zandr/birdnet-mic-halow/releases/2026-10-17/evidence/viewer-review.md

# Visual export review — 2026-10-17

Opened the fresh Fabrication-birdnet-mic-hat.zip in KiCad GerbView. All 11 Gerbers and both drill files loaded. The ZIP importer skipped only the job metadata, as expected; that file remains included in the archive.

Inspected top copper/mask/silk with drills and outline, bottom copper/mask/paste with outline and drills, top paste with In1.Cu, and In2.Cu separately. Registration, board perimeter/notch, jack locating holes and connector pads appear consistent; no obvious export defects observed. Both front-layer PDM routes are present. Bottom silk is intentionally empty. This is a visual export check, not vendor DFM or stencil approval; U1 exposed-pad paste treatment still requires assembler review.

Rendered the schematic and both assembly locator pages to PNG and inspected them. All pages contain the expected drawing, readable labels, fitted/DNP distinction and pin-1 markers; bottom locator is viewed from below. Native fabrication PDF is supplemental.

JLCPCB placement preview, exact ADC sourcing, physical jack-switch test and enclosure/acoustic clearance validation remain outstanding.
