zandr/birdnet-mic-halow/releases/2026-10-17/BOM-birdnet-mic-hat.csv

Comment | Designator | Footprint | LCSC Part # | MPN | Manufacturer | Quantity
1uF | C1,C4,C5,C6,C8,C9 | Capacitor_SMD:C_0402_1005Metric | C167339 | 0402X105K160NT | FH | 6
1uF | C2,C10 | Capacitor_SMD:C_0603_1608Metric | C106248 | CC0603KRX7R7BB105 | YAGEO | 2
0.1uF | C7,C12 | Capacitor_SMD:C_0402_1005Metric | C60474 | CC0402KRX7R7BB104 | YAGEO | 2
PJ-327A0-SMT | J1 | BirdNetMicHat:Jack_3.5mm_PJ-327A0-SMT | C381135 | PJ-327A0-SMT | XKB Connection | 1
DF40HC(3.5)-30DS-0.4V(51) | J3 | BirdNetMicHat:DF40_30_LongWave_Hat | C597945 | DF40HC(3.5)-30DS-0.4V(51) | Hirose | 1
MSM261DGT003 | MK1 | BirdNetMicHat:MSM261DGT003 | C48227730 | MSM261DGT003 | MEMS | 1
MMBT3904 | Q1 | Package_TO_SOT_SMD:SOT-23 | C20526 | MMBT3904 | JSCJ | 1
2.2k | R1 | Resistor_SMD:R_0402_1005Metric | C25879 | 0402WGF2201TCE | UNI-ROYAL | 1
10k | R3,R4,R5 | Resistor_SMD:R_0402_1005Metric | C25744 | 0402WGF1002TCE | UNI-ROYAL | 3
47k | R6 | Resistor_SMD:R_0402_1005Metric | C25792 | 0402WGF4702TCE | UNI-ROYAL | 1
100k | R7 | Resistor_SMD:R_0402_1005Metric | C25741 | 0402WGF1003TCE | UNI-ROYAL | 1
1M | R8 | Resistor_SMD:R_0402_1005Metric | C26083 | 0402WGF1004TCE | UNI-ROYAL | 1
TLV320ADC5140 | U1 | ADC5140_FP:RTW24_4P15X4P15_TEX |  | TLV320ADC5140IRTWR | Texas Instruments | 1
TPS7A2033PDBVR | U2 | Package_TO_SOT_SMD:SOT-23-5 | C2862740 | TPS7A2033PDBVR | Texas Instruments | 1
