zandr/birdnet-mic-halow/releases/2026-10-17/Assembly-placement.pdf

# BirdNET microphone HAT | TOP

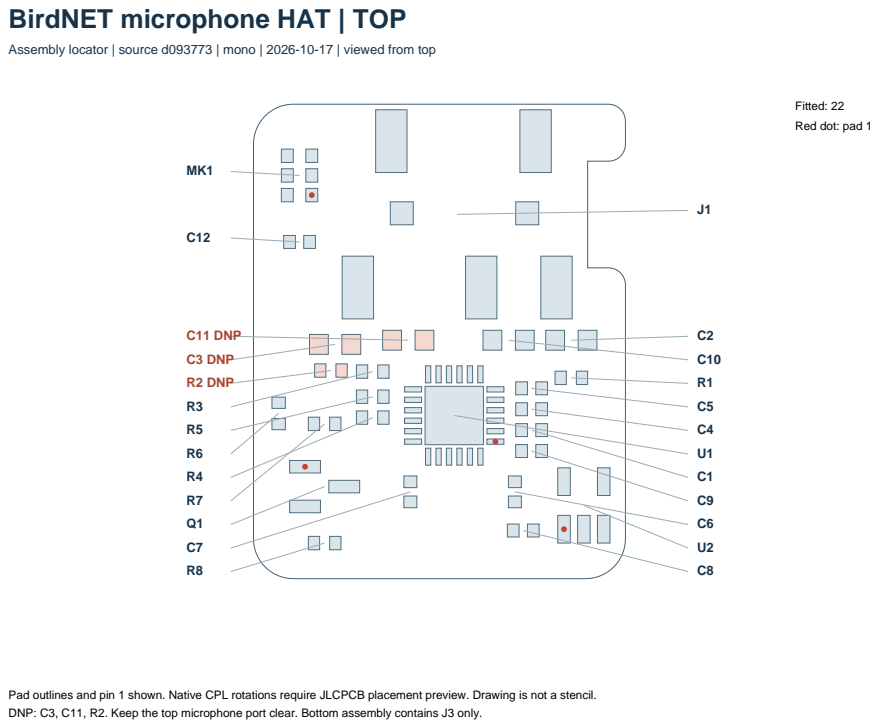
[picture p1: page 1]

Assembly locator | source d093773 | mono | 2026-10-17 | viewed from top

Pad outlines and pin 1 shown. Native CPL rotations require JLCPCB placement preview. Drawing is not a stencil.
DNP: C3, C11, R2. Keep the top microphone port clear. Bottom assembly contains J3 only.

# BirdNET microphone HAT | BOTTOM

Assembly locator | source d093773 | mono | 2026-10-17 | viewed from bottom

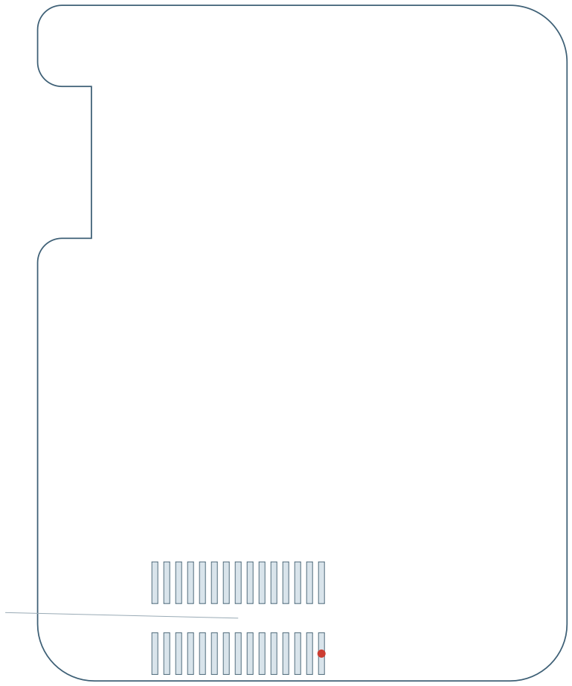
[picture p2: figure]
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

J3

Fitted: 1
Red dot: pad 1
