zandr/birdnet-mic-halow/releases/2026-10-17/Schematic-birdnet-mic-hat.pdf

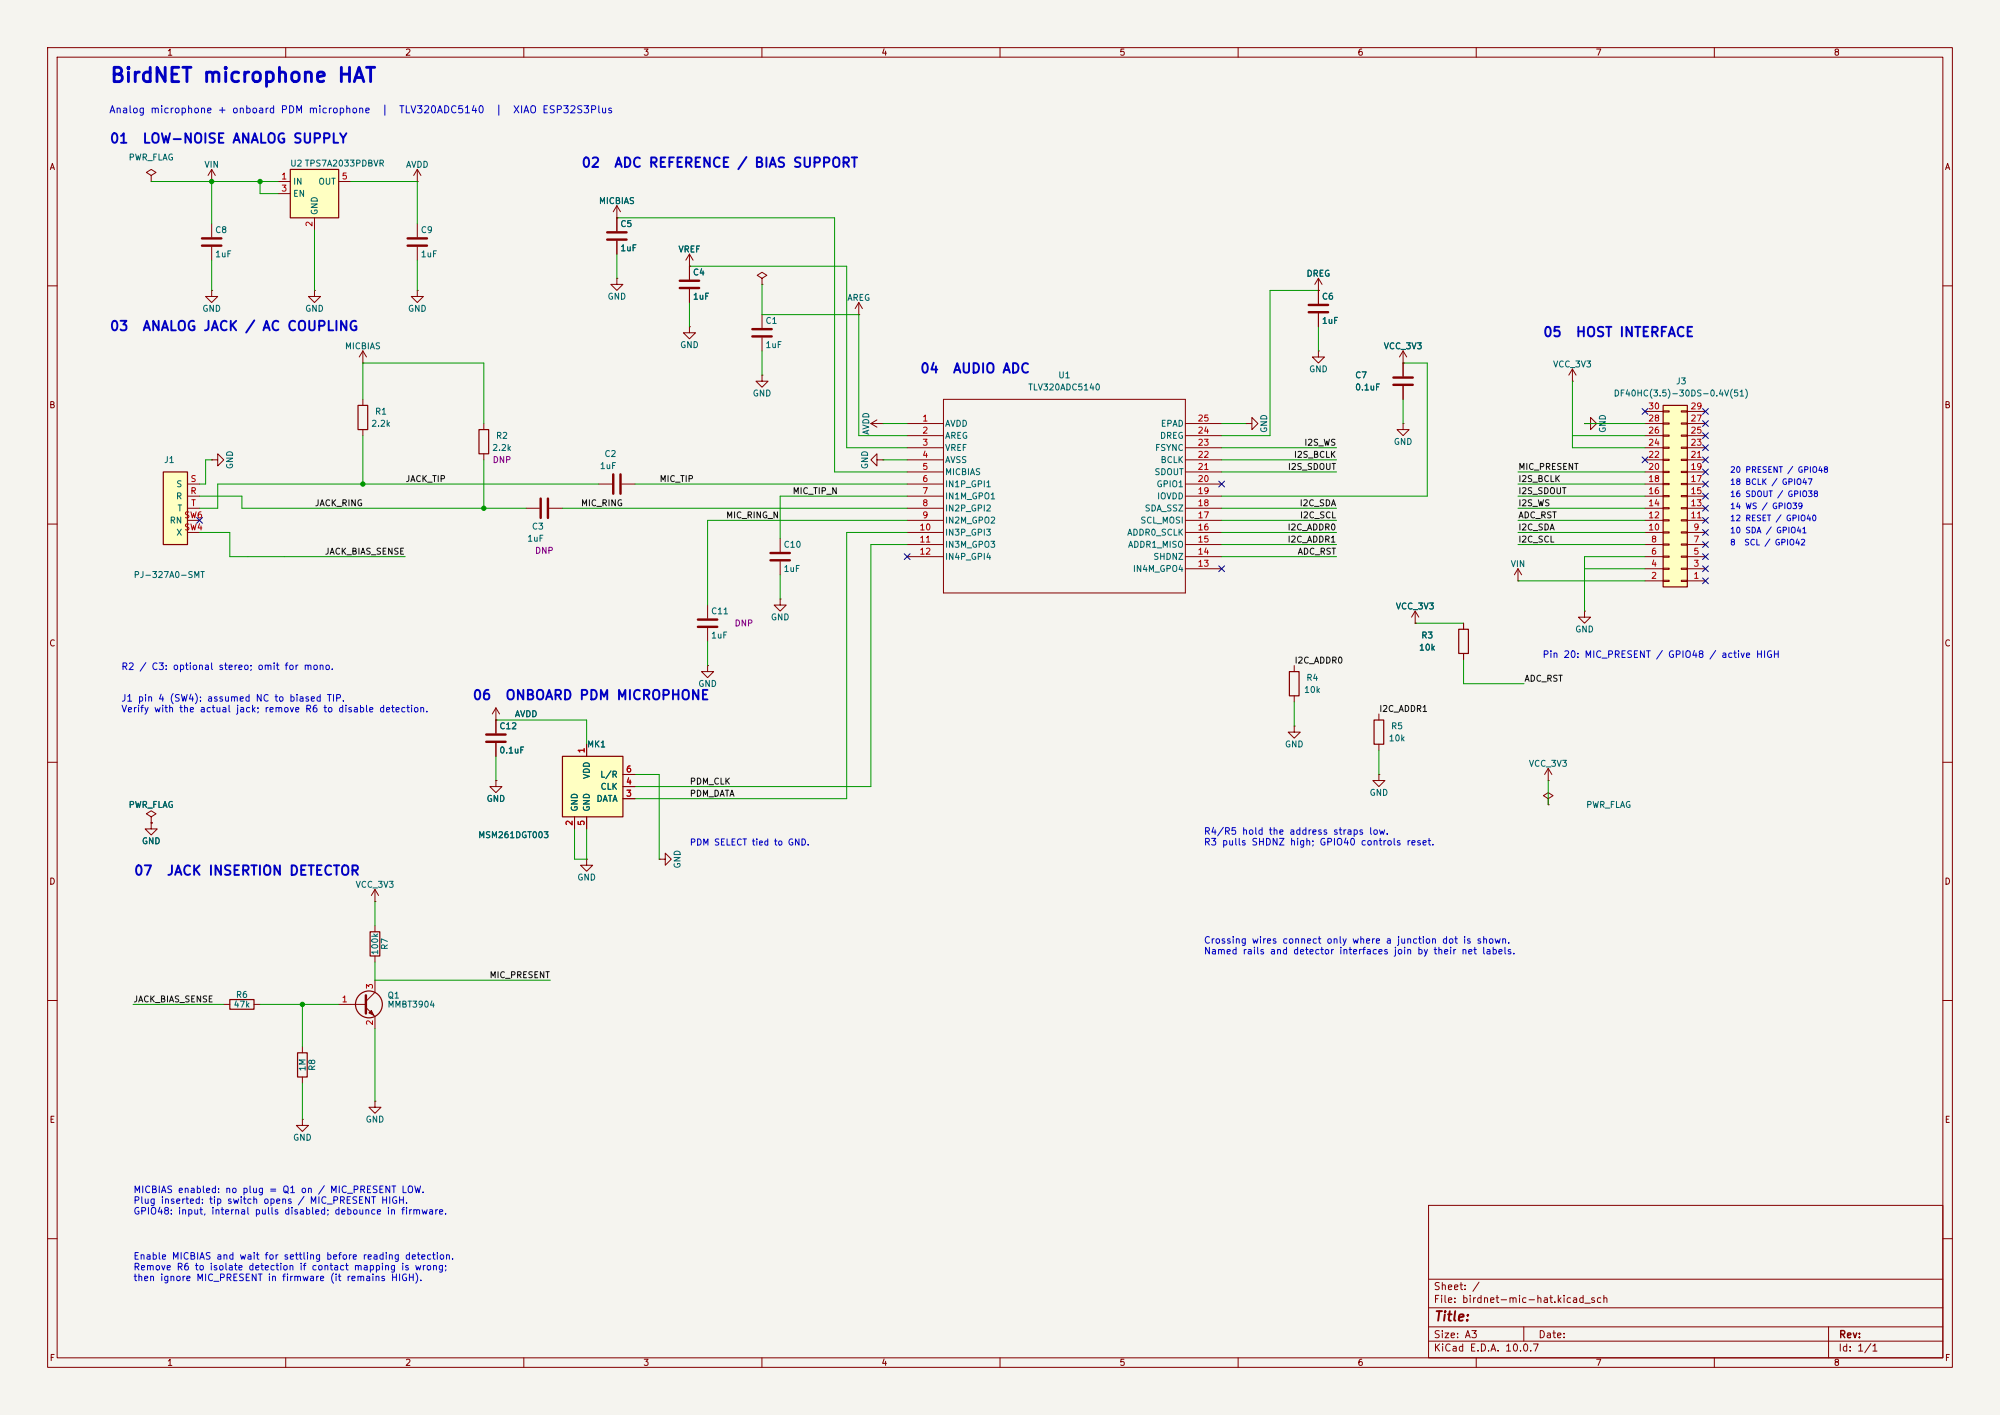
[picture p3: page 1]

Analog microphone + onboard PDM microphone | TLV320ADC5140 | XIAO ESP32S3Plus R2 / C3: optional stereo; omit for mono. 03 ANALOG JACK / AC COUPLING

14 WS / GPIO39 01 LOW-NOISE ANALOG SUPPLY

02 ADC REFERENCE / BIAS SUPPORT

J1 pin 4 (SW4): assumed NC to biased TIP. Verify with the actual jack; remove R6 to disable detection. Enable MICBIAS and wait for settling before reading detection. Remove R6 to isolate detection if contact mapping is wrong; then ignore MIC_PRESENT in firmware (it remains HIGH). MICBIAS enabled: no plug = Q1 on / MIC_PRESENT LOW. Plug inserted: tip switch opens / MIC_PRESENT HIGH. GPIO48: input, internal pulls disabled; debounce in firmware. 07 JACK INSERTION DETECTOR

R4/R5 hold the address straps low. R3 pulls SHDNZ high; GPIO40 controls reset. Crossing wires connect only where a junction dot is shown. Named rails and detector interfaces join by their net labels.

File: birdnet-mic-hat.kicad_sch
Title:

Size: A3 | Rev: | F Date:
KiCad E.D.A. 10.0.7 | Id: 1/1
