zandr/birdnet-mic-halow/releases/2026-10-17/PCB-fabrication.pdf

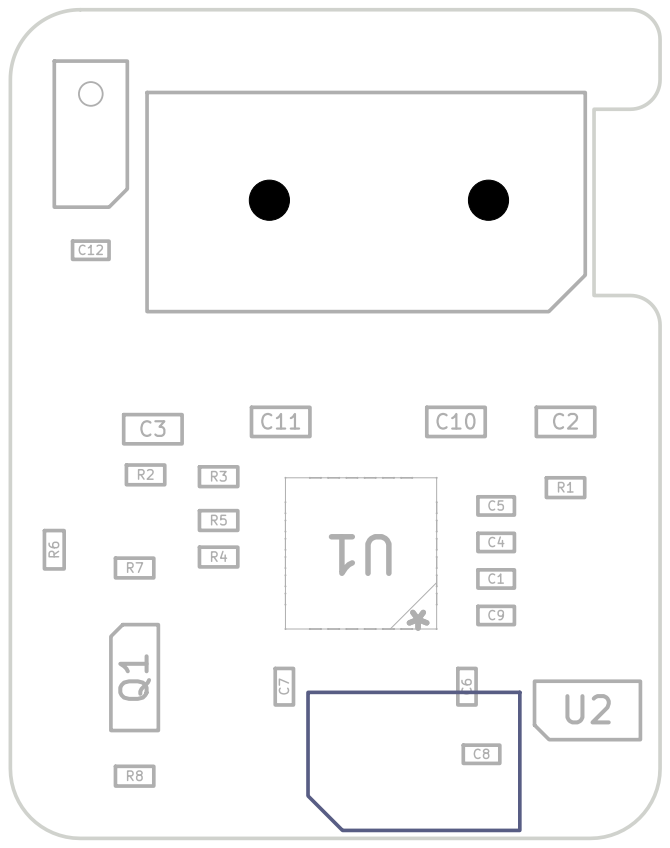
[picture p4: page 1]
