zandr/birdnet-mic-halow/birdnet-mic-hat.kicad_pcb

## KiCad design birdnet-mic-hat.kicad_pcb (2026-10-16)

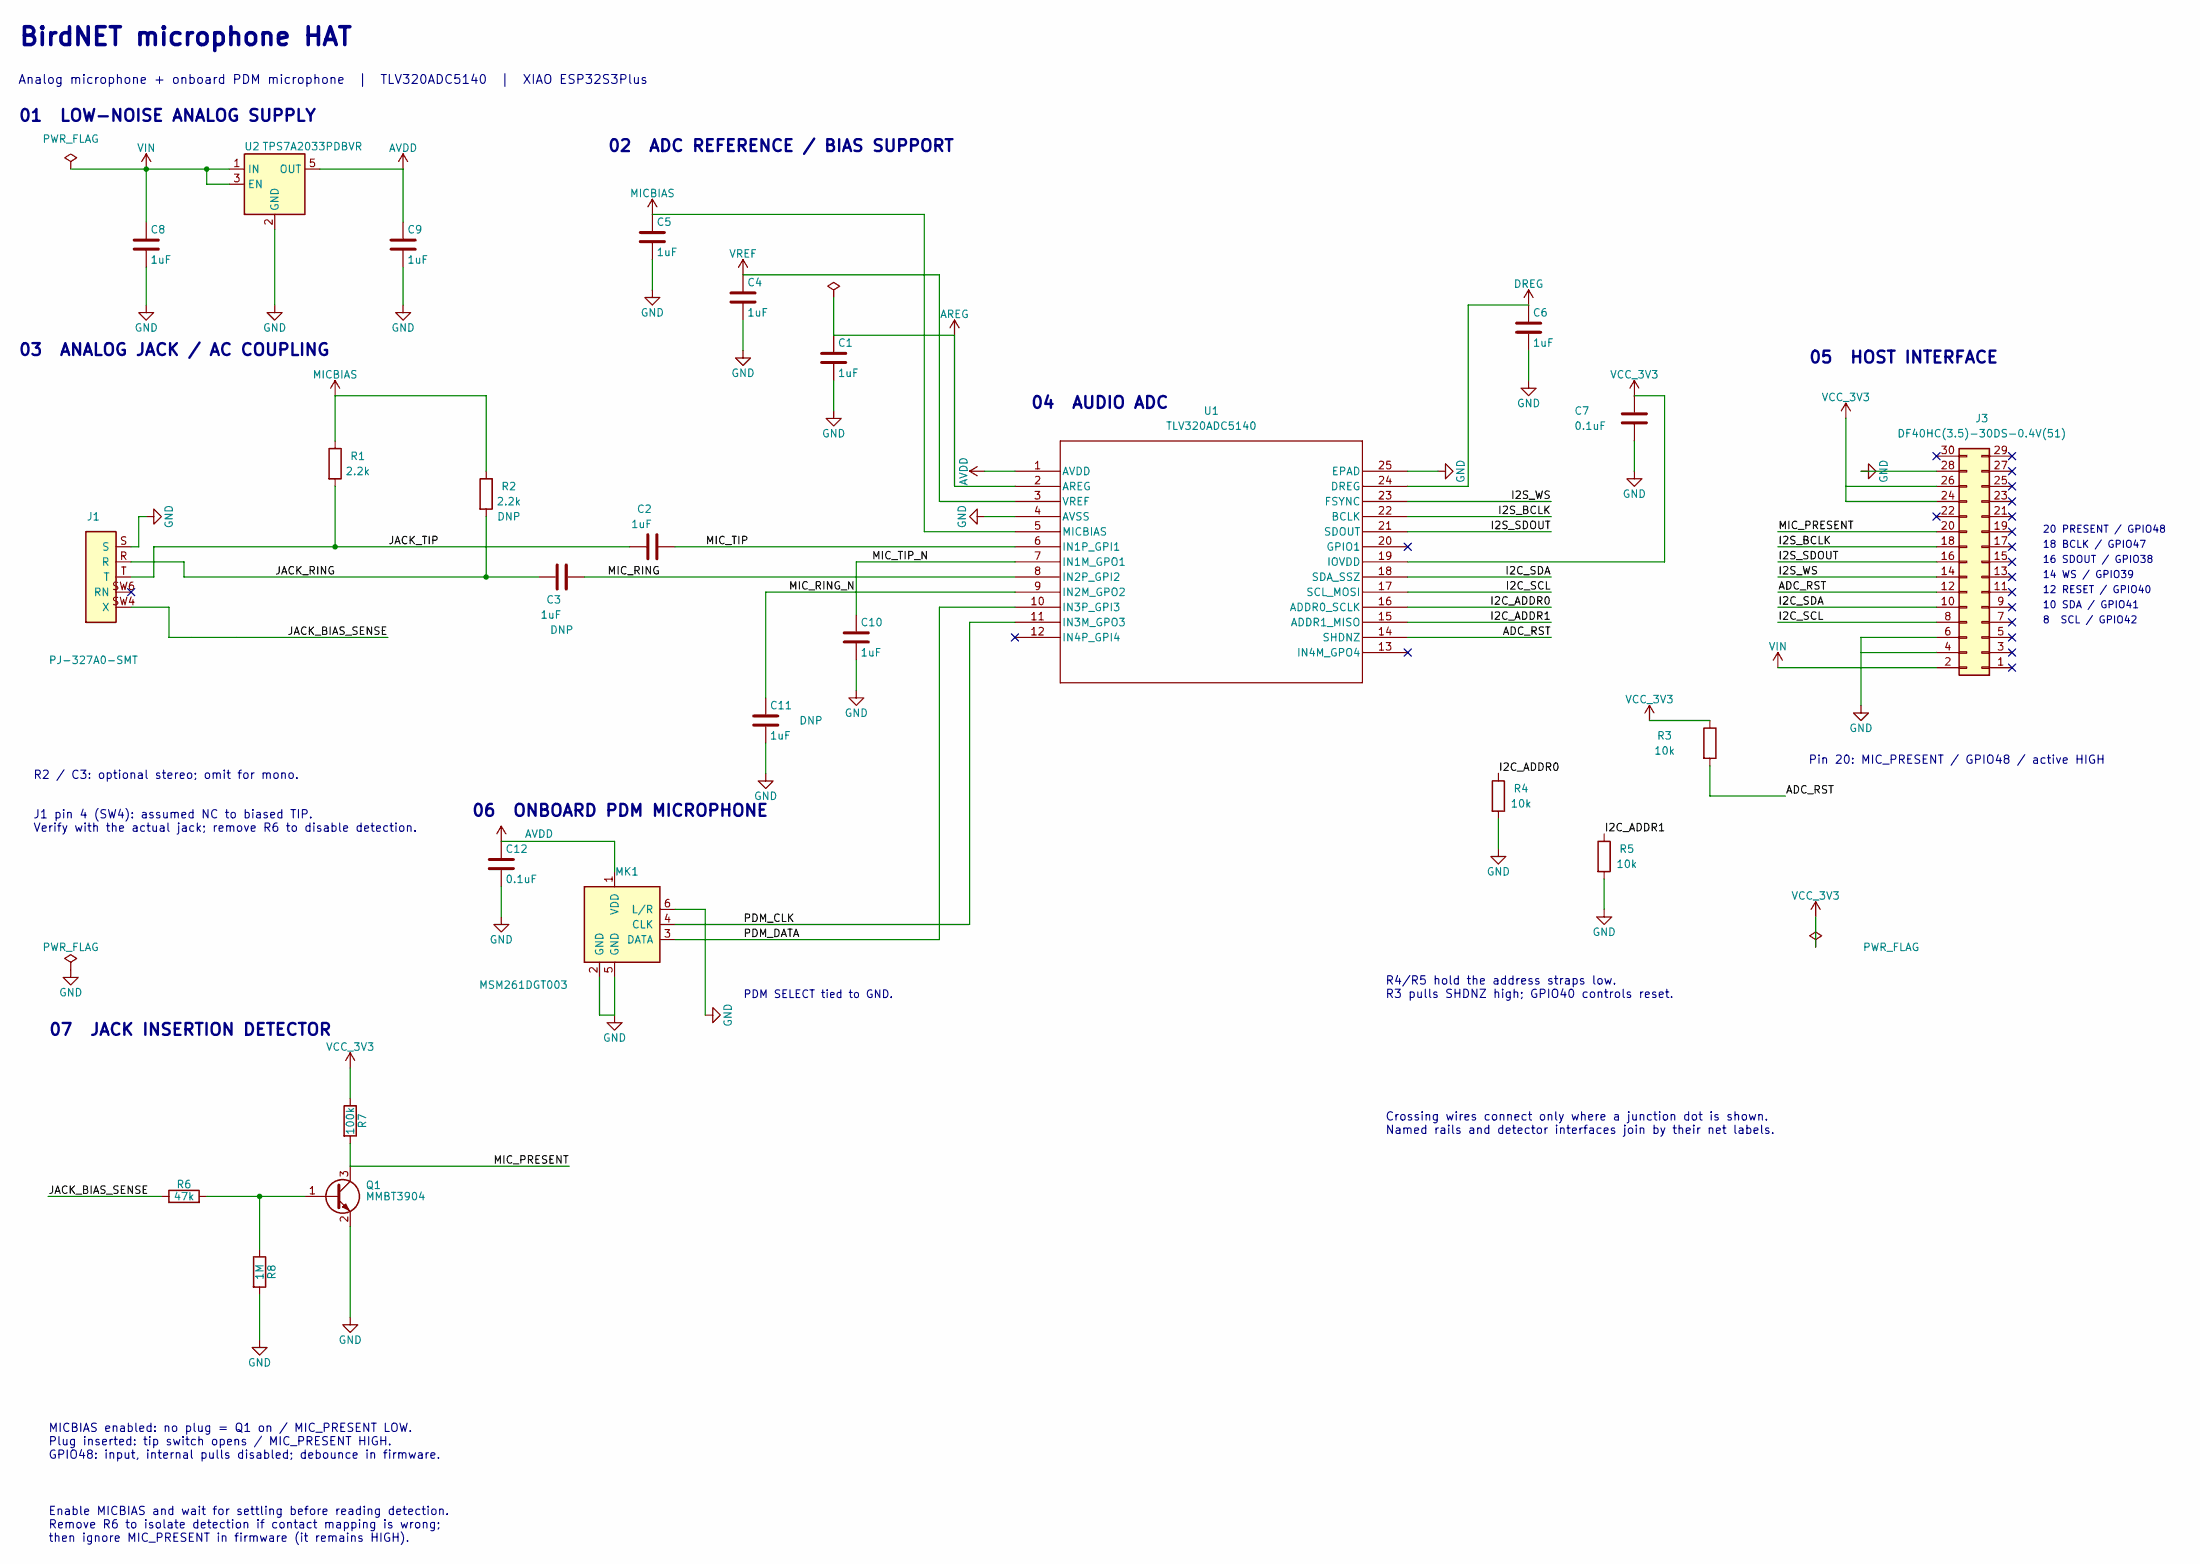
[picture p5: schematic birdnet-mic-hat.kicad_sch]

Parts:
C1, C4, C5, C6, C8, C9: 1uF; C_0402_1005Metric
C2, C3, C10, C11: 1uF; C_0603_1608Metric
C7, C12: 0.1uF; C_0402_1005Metric
J1: PJ-327A0-SMT; Jack_3.5mm_PJ-327A0-SMT; LCSC C381135
J3: DF40HC(3.5)-30DS-0.4V(51); DF40_30_LongWave_Hat
MK1: MSM261DGT003; MPN MSM261DGT003; LCSC C48227730
Q1: MMBT3904; SOT-23; MPN MMBT3904; LCSC C20526
R1, R2: 2.2k; R_0402_1005Metric
R3, R4, R5: 10k; R_0402_1005Metric
R6: 47k; R_0402_1005Metric
R7: 100k; R_0402_1005Metric
R8: 1M; R_0402_1005Metric
U1: TLV320ADC5140; RTW24_4P15X4P15_TEX
U2: TPS7A2033PDBVR; SOT-23-5

Connections:
/ADC_RST: J3.12, R3.2, U1.14 (SHDNZ)
/I2C_ADDR0: R4.1, U1.16 (ADDR0_SCLK)
/I2C_ADDR1: R5.1, U1.15 (ADDR1_MISO)
/I2C_SCL: J3.8, U1.17 (SCL_MOSI)
/I2C_SDA: J3.10, U1.18 (SDA_SSZ)
/I2S_BCLK: J3.18, U1.22 (BCLK)
/I2S_SDOUT: J3.16, U1.21 (SDOUT)
/I2S_WS: J3.14, U1.23 (FSYNC)
/JACK_BIAS_SENSE: J1.SW4 (X), R6.1
/JACK_RING: C3.1, J1.R, R2.2
/JACK_TIP: C2.1, J1.T, R1.2
/MIC_PRESENT: J3.20, Q1.3 (C), R7.2
/MIC_RING: C3.2, U1.8 (IN2P_GPI2)
/MIC_RING_N: C11.1, U1.9 (IN2M_GPO2)
/MIC_TIP: C2.2, U1.6 (IN1P_GPI1)
/MIC_TIP_N: C10.1, U1.7 (IN1M_GPO1)
/PDM_CLK: MK1.4 (CLK), U1.11 (IN3M_GPO3)
/PDM_DATA: MK1.3 (DATA), U1.10 (IN3P_GPI3)
AREG: C1.1, U1.2 (AREG)
AVDD: C9.1, C12.1, MK1.1 (VDD), U1.1 (AVDD), U2.5 (OUT)
DREG: C6.1, U1.24 (DREG)
GND: C1.2, C4.2, C5.2, C6.2, C7.2, C8.2, C9.2, C10.2, C11.2, C12.2, J1.S, J3.4, J3.6, J3.28, MK1.2 (GND), MK1.5 (GND), MK1.6 (L/R), Q1.2 (E), R4.2, R5.2, R8.2, U1.4 (AVSS), U1.25 (EPAD), U2.2 (GND)
MICBIAS: C5.1, R1.1, R2.1, U1.5 (MICBIAS)
unnamed: Q1.1 (B), R6.2, R8.1
VCC_3V3: C7.1, J3.24, J3.26, R3.1, R7.1, U1.19 (IOVDD)
VIN: C8.1, J3.2, U2.1 (IN), U2.3 (EN)
VREF: C4.1, U1.3 (VREF)

Notes on the sheet:
R4/R5 hold the address straps low. R3 pulls SHDNZ high; GPIO40 controls reset.
02 ADC REFERENCE / BIAS SUPPORT
16 SDOUT / GPIO38
12 RESET / GPIO40
8 SCL / GPIO42
Pin 20: MIC_PRESENT / GPIO48 / active HIGH
14 WS / GPIO39
01 LOW-NOISE ANALOG SUPPLY
06 ONBOARD PDM MICROPHONE
R2 / C3: optional stereo; omit for mono.
18 BCLK / GPIO47
MICBIAS enabled: no plug = Q1 on / MIC_PRESENT LOW. Plug inserted: tip switch opens / MIC_PRESENT HIGH. GPIO48: input, internal pulls disabled; debounce in firmware.
20 PRESENT / GPIO48
10 SDA / GPIO41
04 AUDIO ADC
PDM SELECT tied to GND.
BirdNET microphone HAT
03 ANALOG JACK / AC COUPLING
Crossing wires connect only where a junction dot is shown. Named rails and detector interfaces join by their net labels.
Analog microphone + onboard PDM microphone | TLV320ADC5140 | XIAO ESP32S3Plus
07 JACK INSERTION DETECTOR
05 HOST INTERFACE
J1 pin 4 (SW4): assumed NC to biased TIP. Verify with the actual jack; remove R6 to disable detection.
Enable MICBIAS and wait for settling before reading detection. Remove R6 to isolate detection if contact mapping is wrong; then ignore MIC_PRESENT in firmware (it remains HIGH).

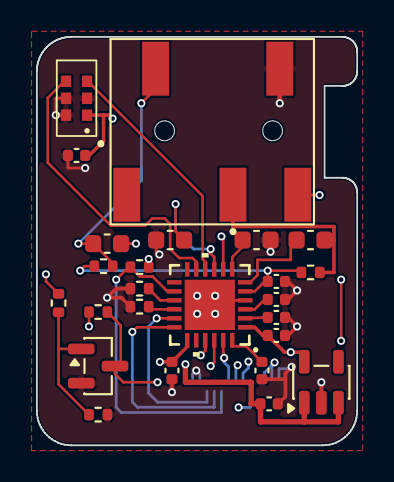
[picture p6: board birdnet-mic-hat.kicad_pcb from above]

Board: 4 copper layers, 17.8 x 22.7 mm, 26 parts (1 on the bottom side), 27 nets.
