zandr/birdnet-mic-halow/(commit log)

2026-10-13 Initial BirdNET mic hat KiCad design
    [birdnet-mic-hat.kicad_pcb, birdnet-mic-hat.kicad_sch]
2026-10-13 Replace jack detector comparator with transistor and removable link
    [birdnet-mic-hat.kicad_pcb, birdnet-mic-hat.kicad_sch]
2026-10-13 Remove redundant jack detection link; retain 0402 base resistor
    [birdnet-mic-hat.kicad_pcb, birdnet-mic-hat.kicad_sch]
2026-10-14 Hide all reference designators and add visible pin-one dots
    [birdnet-mic-hat.kicad_pcb]
2026-10-14 Remove manually placed C12 and J1 silkscreen labels
    [birdnet-mic-hat.kicad_pcb]
2026-10-14 Remove remaining MIC and MIC HAT silkscreen text
    [birdnet-mic-hat.kicad_pcb]
2026-10-14 Add mono prototype fabrication and assembly release package
    [BOM-birdnet-mic-hat.csv, DNP.csv, Sourcing.csv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]
2026-10-16 Save manual routing refinements before trace cleanup
    [birdnet-mic-hat.kicad_pcb]
2026-10-16 Clean supply and signal routing and remove redundant via
    [birdnet-mic-hat.kicad_pcb]
2026-10-16 Route PDM signals on front copper and remove seven signal vias
    [birdnet-mic-hat.kicad_pcb]
2026-10-17 Publish 2026-10-17 prototype release package
    [BOM-birdnet-mic-hat.csv, DNP.csv, Sourcing.csv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]
